MiataMike/RetroFuture-Dash/budget.png

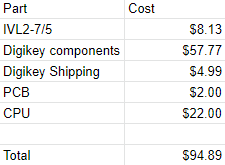
budget.png
