MiataMike/RetroFuture-Dash/BOM/2019-10-24T024712.xlsx

Index | Quantity | Part Number | Manufacturer Part Number | Description | Customer Reference | Available | Backorder | Unit Price | Extended Price USD
1 | 1 | PDV-P8103-ND | PDV-P8103 | PHOTOCELL 16-33KOHM |  | 1 | 0 | 0.89 | 0.89
2 | 1 | MBR0530CT-ND | MBR0530 | DIODE SCHOTTKY 30V 500MA SOD123 |  | 1 | 0 | 0.35 | 0.35
3 | 1 | 732-1416-ND | 7447054 | FIXED IND 10UH 2A 20 MOHM TH |  | 1 | 0 | 2.05 | 2.05
4 | 1 | 641-1310-1-ND | 1N4001-G | DIODE GEN PURP 50V 1A DO41 |  | 1 | 0 | 0.1 | 0.10
5 | 1 | 1N4749AFSCT-ND | 1N4749ATR | DIODE ZENER 24V 1W DO41 |  | 1 | 0 | 0.25 | 0.25
6 | 1 | 4N25SM-ND | 4N25SM | OPTOISO 4.17KV TRANS W/BASE 6SMD |  | 1 | 0 | 0.64 | 0.64
7 | 1 | P390ADCT-ND | ERJ-P06J391V | RES SMD 390 OHM 5% 1/2W 0805 |  | 1 | 0 | 0.13 | 0.13
8 | 2 | 399-1142-1-ND | C0805C471K5RACTU | CAP CER 470PF 50V X7R 0805 |  | 2 | 0 | 0.12 | 0.24
9 | 1 | RNCP0805FTD10K0CT-ND | RNCP0805FTD10K0 | RES 10K OHM 1% 1/4W 0805 |  | 1 | 0 | 0.1 | 0.10
10 | 1 | RMCF0805ZT0R00CT-ND | RMCF0805ZT0R00 | RES 0 OHM JUMPER 1/8W 0805 |  | 1 | 0 | 0.1 | 0.10
11 | 1 | LM340SX-12/NOPBCT-ND | LM340SX-12/NOPB | IC REG LIN 12V 1A DDPAK/TO263-3 |  | 1 | 0 | 1.58 | 1.58
12 | 1 | 1276-1768-1-ND | CL21C121JBANNNC | CAP CER 120PF 50V C0G/NP0 0805 |  | 1 | 0 | 0.1 | 0.10
13 | 1 | A126334CT-ND | CRG0805F11K | RES SMD 11K OHM 1% 1/8W 0805 |  | 1 | 0 | 0.1 | 0.10
14 | 1 | 311-205KCRCT-ND | RC0805FR-07205KL | RES SMD 205K OHM 1% 1/8W 0805 |  | 1 | 0 | 0.1 | 0.10
15 | 1 | ML07G-1-ND | 8125/07 100 | CBL RIBN 7COND 0.100 GRAY 1' |  | 0 | 1 | 3.3 | 3.30
16 | 1 | 493-11353-1-ND | UPW1E4R7MDD1TD | CAP ALUM 4.7UF 20% 25V RADIAL |  | 1 | 0 | 0.29 | 0.29
17 | 4 | 399-1177-1-ND | C0805C104Z5VACTU | CAP CER 0.1UF 50V Y5V 0805 |  | 4 | 0 | 0.1 | 0.40
18 | 1 | 490-10751-1-ND | GRM21BR61H475KE51L | CAP CER 4.7UF 50V X5R 0805 |  | 1 | 0 | 0.37 | 0.37
19 | 1 | 1276-2880-1-ND | CL31A475KAHNNNE | CAP CER 4.7UF 25V X5R 1206 |  | 1 | 0 | 0.22 | 0.22
20 | 1 | 1276-2903-1-ND | CL21A225KPFNNWE | CAP CER 2.2UF 10V X5R 0805 |  | 1 | 0 | 0.11 | 0.11
21 | 1 | MAX6920AWP+-ND | MAX6920AWP+ | IC DRVR VFD TUBE SRL 20SOIC |  | 1 | 0 | 5.59 | 5.59
22 | 1 | 296-2701-1-ND | TPS76325DBVT | IC REG LINEAR 2.5V 150MA SOT23-5 |  | 1 | 0 | 0.93 | 0.93
23 | 1 | 1568-1981-ND | COM-14965 | LUMINI LED RING 3" 60XAPA102-202 |  | 1 | 0 | 25.95 | 25.95
24 | 3 | A27628CT-ND | 61988-2 | CONN QC RCPT/TAB 18-22AWG 0.250 |  | 3 | 0 | 0.35 | 1.05
25 | 1 | CN528B-25-ND | 1569-22-1-0500-001-1-TS | HOOK-UP STRND 22AWG 300V BLK 25' |  | 1 | 0 | 5.91 | 5.91
26 | 1 | A132500-ND | 130046 | CONN RING CIRC 16-22AWG M6 CRIMP |  | 1 | 0 | 0.45 | 0.45
27 | 1 | LM1084ISX-5.0/NOPBCT-ND | LM1084ISX-5.0/NOPB | IC REG LIN 5V 5A DDPAK/TO263-3 |  | 1 | 0 | 2.65 | 2.65
28 | 1 | 296-38771-1-ND | LMR64010XMFX/NOPB | IC REG BOOST ADJ 1A SOT23-5 |  | 1 | 0 | 1.6 | 1.60
29 | 4 | 1772-1976-ND | 4532-440-AL-7 | HEX STANDOFF #4-40 ALUMINUM 3/8" |  | 4 | 0 | 0.38 | 1.52
30 | 1 | 36-9600-ND | 9600 | HEX NUT 1/4" STEEL 4-40 |  | 1 | 0 | 0.1 | 0.10
31 | 6 | 36-9900-ND | 9900 | MACHINE SCREW PAN PHILLIPS 4-40 |  | 6 | 0 | 0.1 | 0.60
