MiataMike/RetroFuture-Dash/DesignVFD-Ring.brd

## EAGLE design DesignVFD-Ring.brd (2019-10-30)

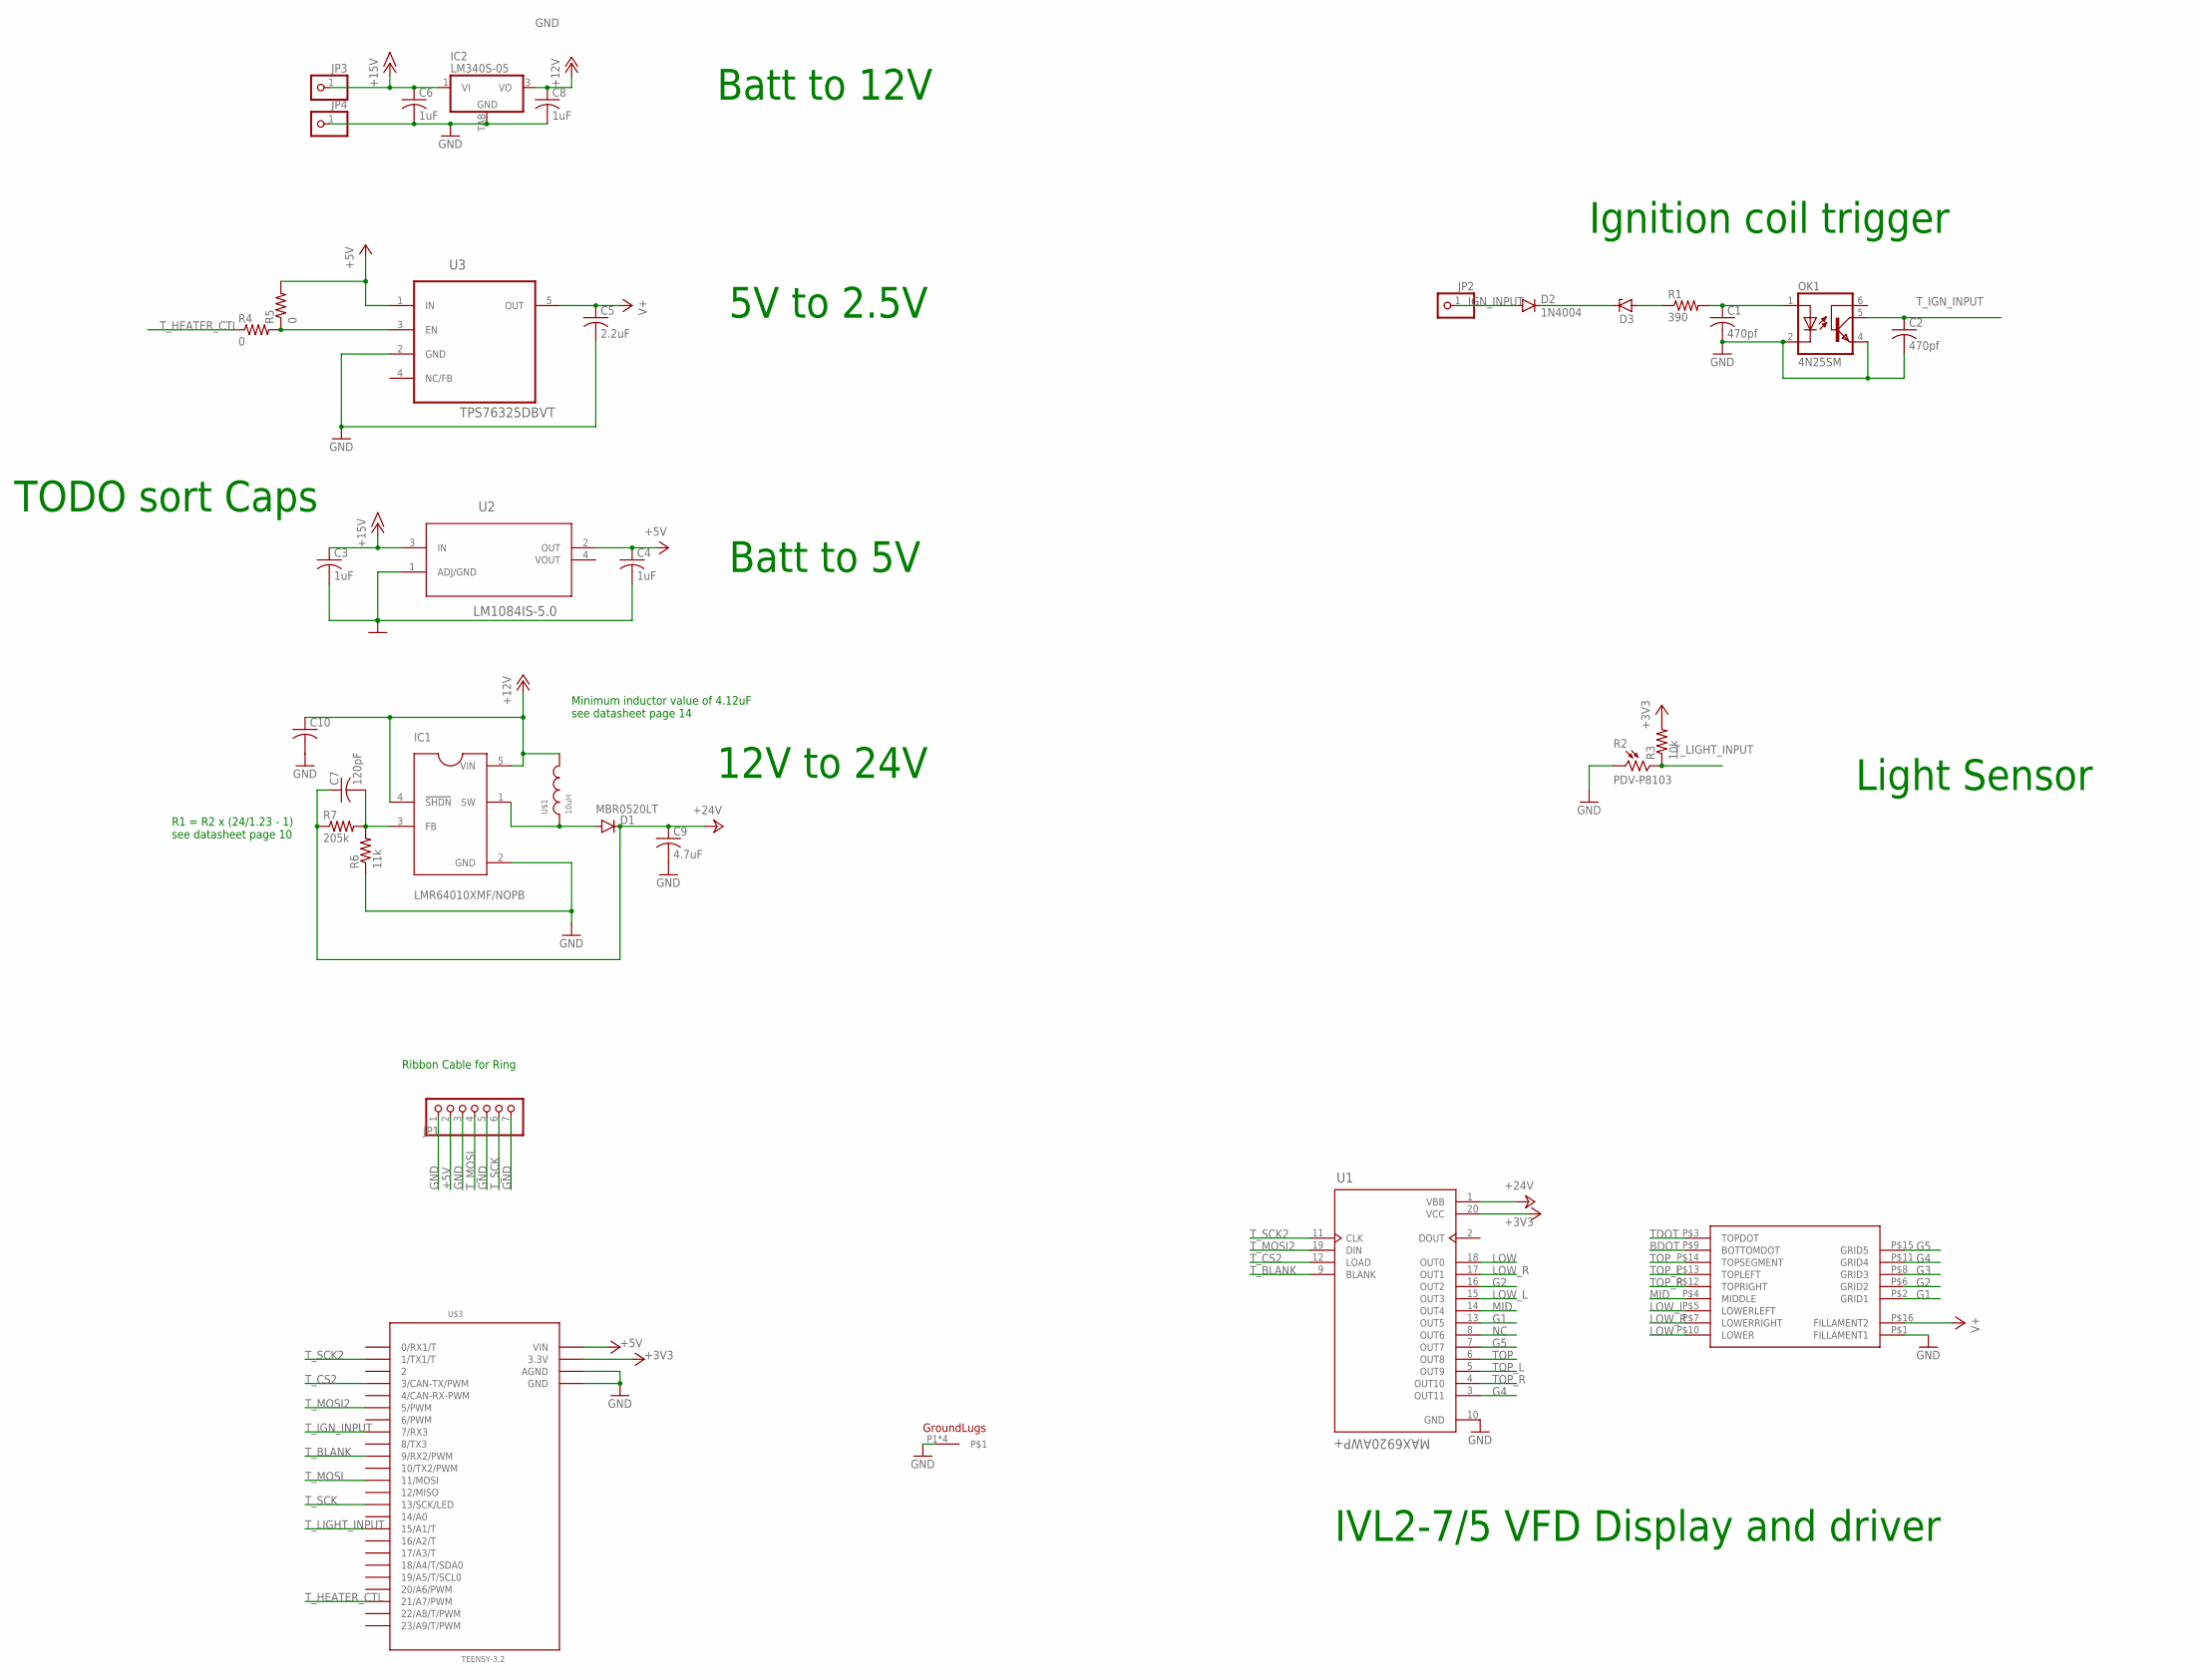
[picture p2: schematic DesignVFD-Ring.sch]

Parts:
C1, C2: 470pf; C0805
C3, C4, C6, C8: 1uF; C0805
C5: 2.2uF; C0805
C7: 120pF; C0805
C9: 4.7uF; C0805
C10: C-US025-050X050; C025-050X050
D1: MBR0520LT; SOD123
D2: 1N4004; DO41-10
D3: ZENER-DIODEDO41Z10; DO41Z10
IC1: LMR64010XMF/NOPB; SOT95P280X145-5N
IC2: LM340S-05; TO263-3
JP1: PINHD-1X7; 1X07
JP2, JP3, JP4: PINHD-1X1; 1X01
OK1: 4N25SM; DIL6-SMD
R1: 390; R0805
R2: PDV-P8103; PHODET_PDV-P8103
R3: 10k; R0805
R4, R5: 0; R0805
R6: 11k; R0805
R7: 205k; R0805
U1: MAX6920AWP+; SOIC127P1032X265-20N
U2: LM1084IS-5.0; TO254P1435X457-3N
U3: TPS76325DBVT; SOT95P280X145-5N
U$1: 10uH; 732-1416-ND
U$2: IVL2-7/5
U$3: TEENSY-3.2; TEENSY3.2
U$4: LUMINI3; STANDOFF-ELECTRICAL

Connections:
+3V3: R3.2, U1.20 (VCC), U$3.3V3+ (3.3V)
+5V: C4.1, JP1.2, R5.2, U2.2 (OUT), U3.1 (IN), U$3.VIN
+12V: C8.1, C10.1, IC1.4 (!SHDN), IC1.5 (VIN), IC2.3 (VO), U$1.P$2
+15V: C3.1, C6.1, IC2.1 (VI), JP3.1, U2.3 (IN)
+24V: C7.1, C9.1, D1.C, R7.1, U1.1 (VBB)
BDOT: U$2.P$9 (BOTTOMDOT)
G1: U1.13 (OUT5), U$2.P$2 (GRID1)
G2: U1.16 (OUT2), U$2.P$6 (GRID2)
G3: U$2.P$8 (GRID3)
G4: U1.3 (OUT11), U$2.P$11 (GRID4)
G5: U1.7 (OUT7), U$2.P$15 (GRID5)
GND: C1.2, C2.2, C3.2, C4.2, C5.2, C6.2, C8.2, C9.2, C10.2, IC1.2 (GND), IC2.TAB (GND), JP1.1, JP1.3, JP1.5, JP1.7, JP4.1, OK1.2 (C), OK1.4 (EMI), R2.1, R6.1, U1.10 (GND), U2.1 (ADJ/GND), U3.2 (GND), U$2.P$1 (FILLAMENT1), U$3.AGND, U$3.GND, U$4.P1, U$4.P2, U$4.P3, U$4.P4
IGN_INPUT: D2.A, JP2.1
LOW: U1.18 (OUT0), U$2.P$10 (LOWER)
LOW_L: U1.15 (OUT3), U$2.P$5 (LOWERLEFT)
LOW_R: U1.17 (OUT1), U$2.P$7 (LOWERRIGHT)
MID: U1.14 (OUT4), U$2.P$4 (MIDDLE)
unnamed: R4.2, R5.1, U3.3 (EN)
unnamed: D2.C, D3.C
unnamed: D3.A, R1.1
unnamed: C1.1, OK1.1 (A), R1.2
unnamed: D1.A, IC1.1 (SW), U$1.P$1
unnamed: C7.2, IC1.3 (FB), R6.2, R7.2
NC: U1.8 (OUT6)
TDOT: U$2.P$3 (TOPDOT)
TOP: U1.6 (OUT8), U$2.P$14 (TOPSEGMENT)
TOP_L: U1.5 (OUT9), U$2.P$13 (TOPLEFT)
TOP_R: U1.4 (OUT10), U$2.P$12 (TOPRIGHT)
T_BLANK: U1.9 (BLANK), U$3.9 (9/RX2/PWM)
T_CS2: U1.12 (LOAD), U$3.3 (3/CAN-TX/PWM)
T_HEATER_CTL: R4.1, U$3.21 (21/A7/PWM)
T_IGN_INPUT: C2.1, OK1.5 (COL), U$3.7 (7/RX3)
T_LIGHT_INPUT: R2.2, R3.1, U$3.15 (15/A1/T)
T_MOSI: JP1.4, U$3.11 (11/MOSI)
T_MOSI2: U1.19 (DIN), U$3.5 (5/PWM)
T_SCK: JP1.6, U$3.13 (13/SCK/LED)
T_SCK2: U1.11 (CLK), U$3.1 (1/TX1/T)
V+: C5.1, U3.5 (OUT), U$2.P$16 (FILLAMENT2)

Notes on the sheet:
Ribbon Cable for Ring
TODO sort Caps
Batt to 12V
5V to 2.5V
Batt to 5V
12V to 24V
Ignition coil trigger
IVL2-7/5 VFD Display and driver
Light Sensor
R1 = R2 x (24/1.23 - 1) see datasheet page 10
Minimum inductor value of 4.12uF see datasheet page 14

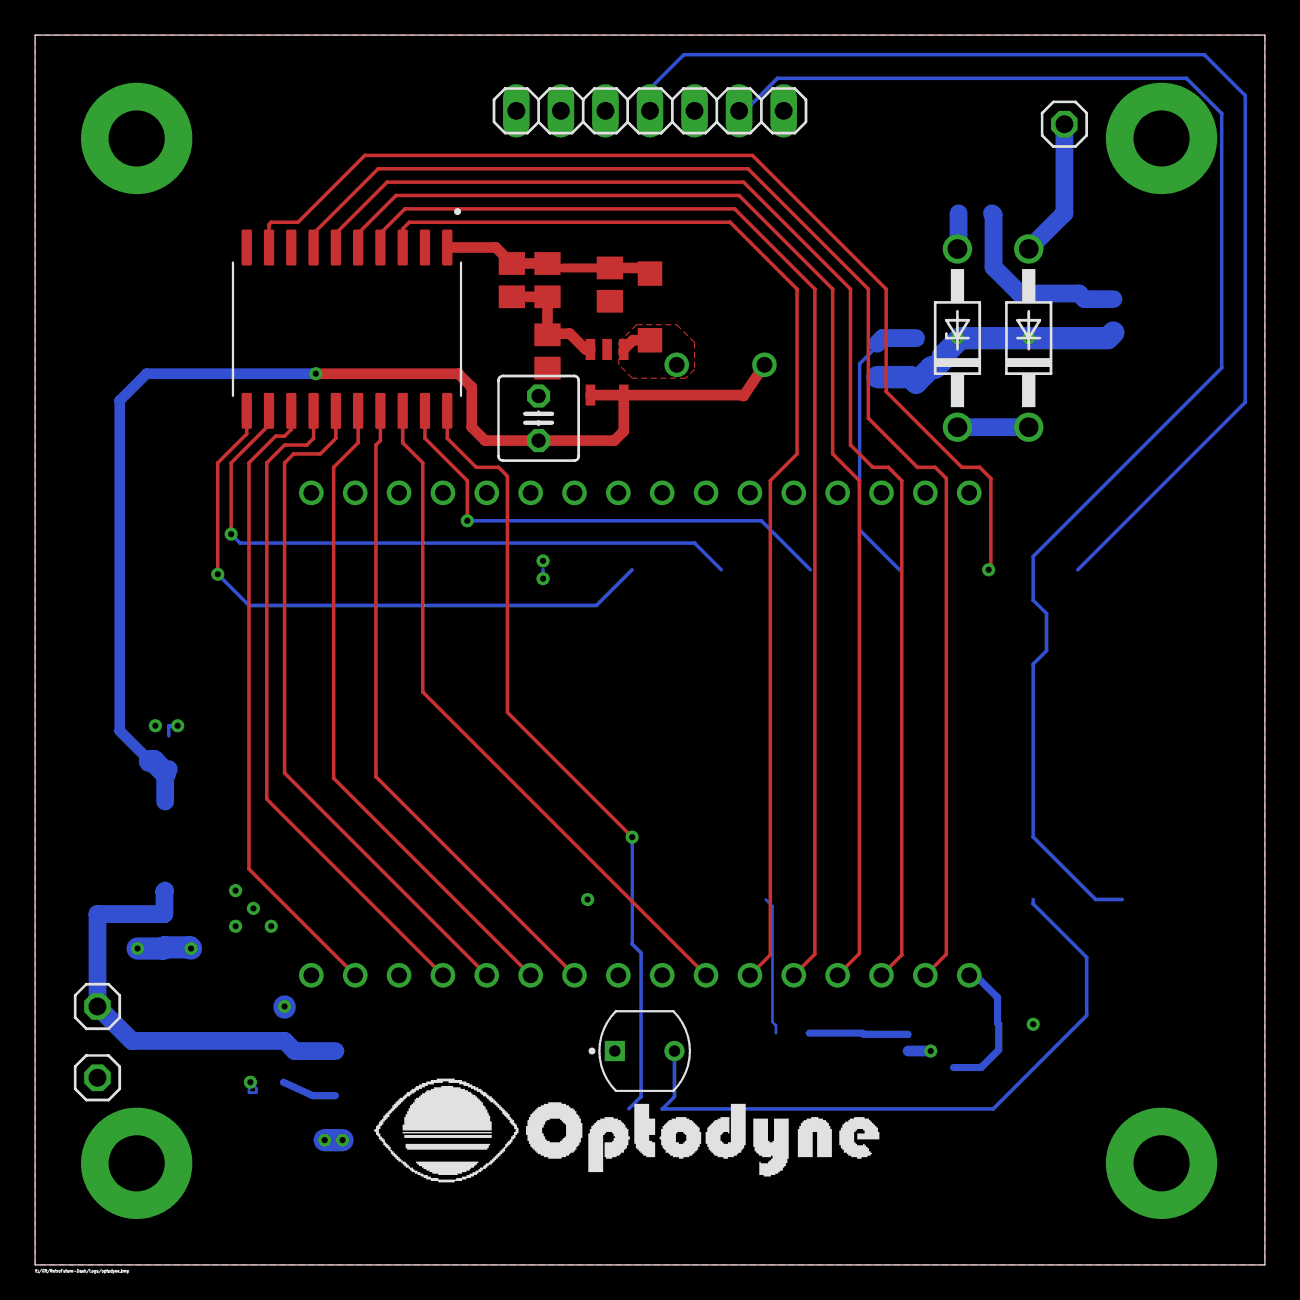
[picture p3: board DesignVFD-Ring.brd from above]

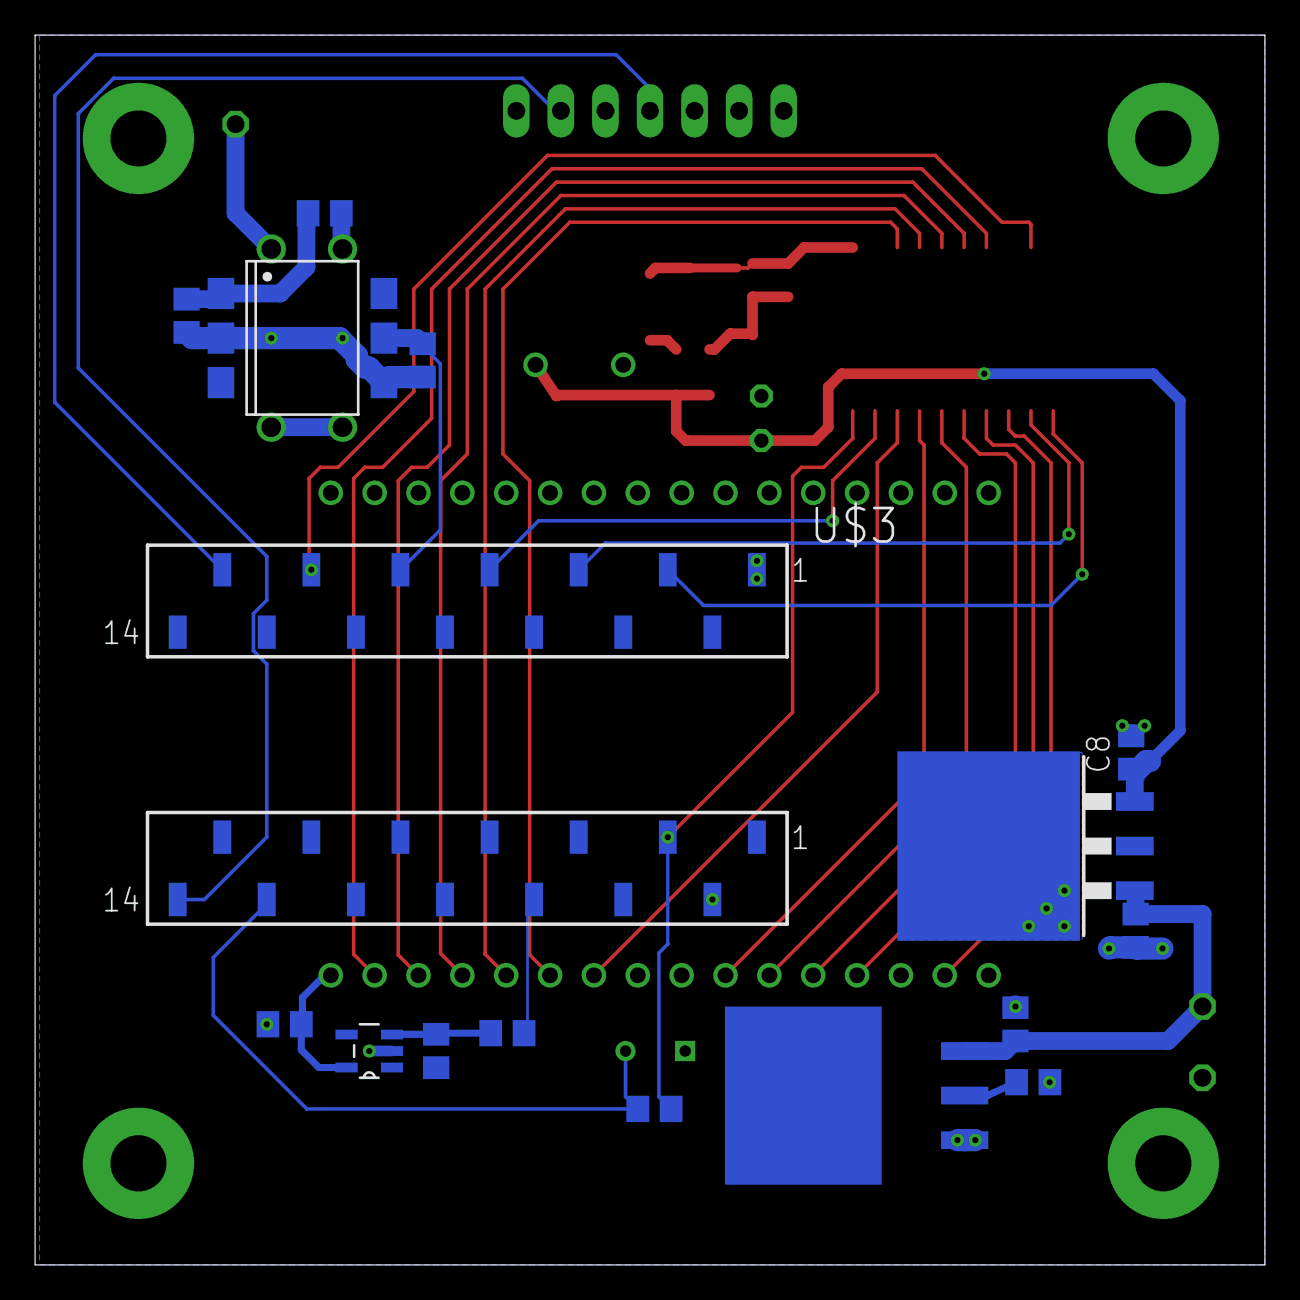
[picture p4: board DesignVFD-Ring.brd from below]

Board: 2 copper layers, 70.1 x 70.1 mm, 34 parts (16 on the bottom side), 34 nets.
