MiataMike/RetroFuture-Dash/LuMini_3Inch.brd

## EAGLE design LuMini_3Inch.brd (2019-10-24)

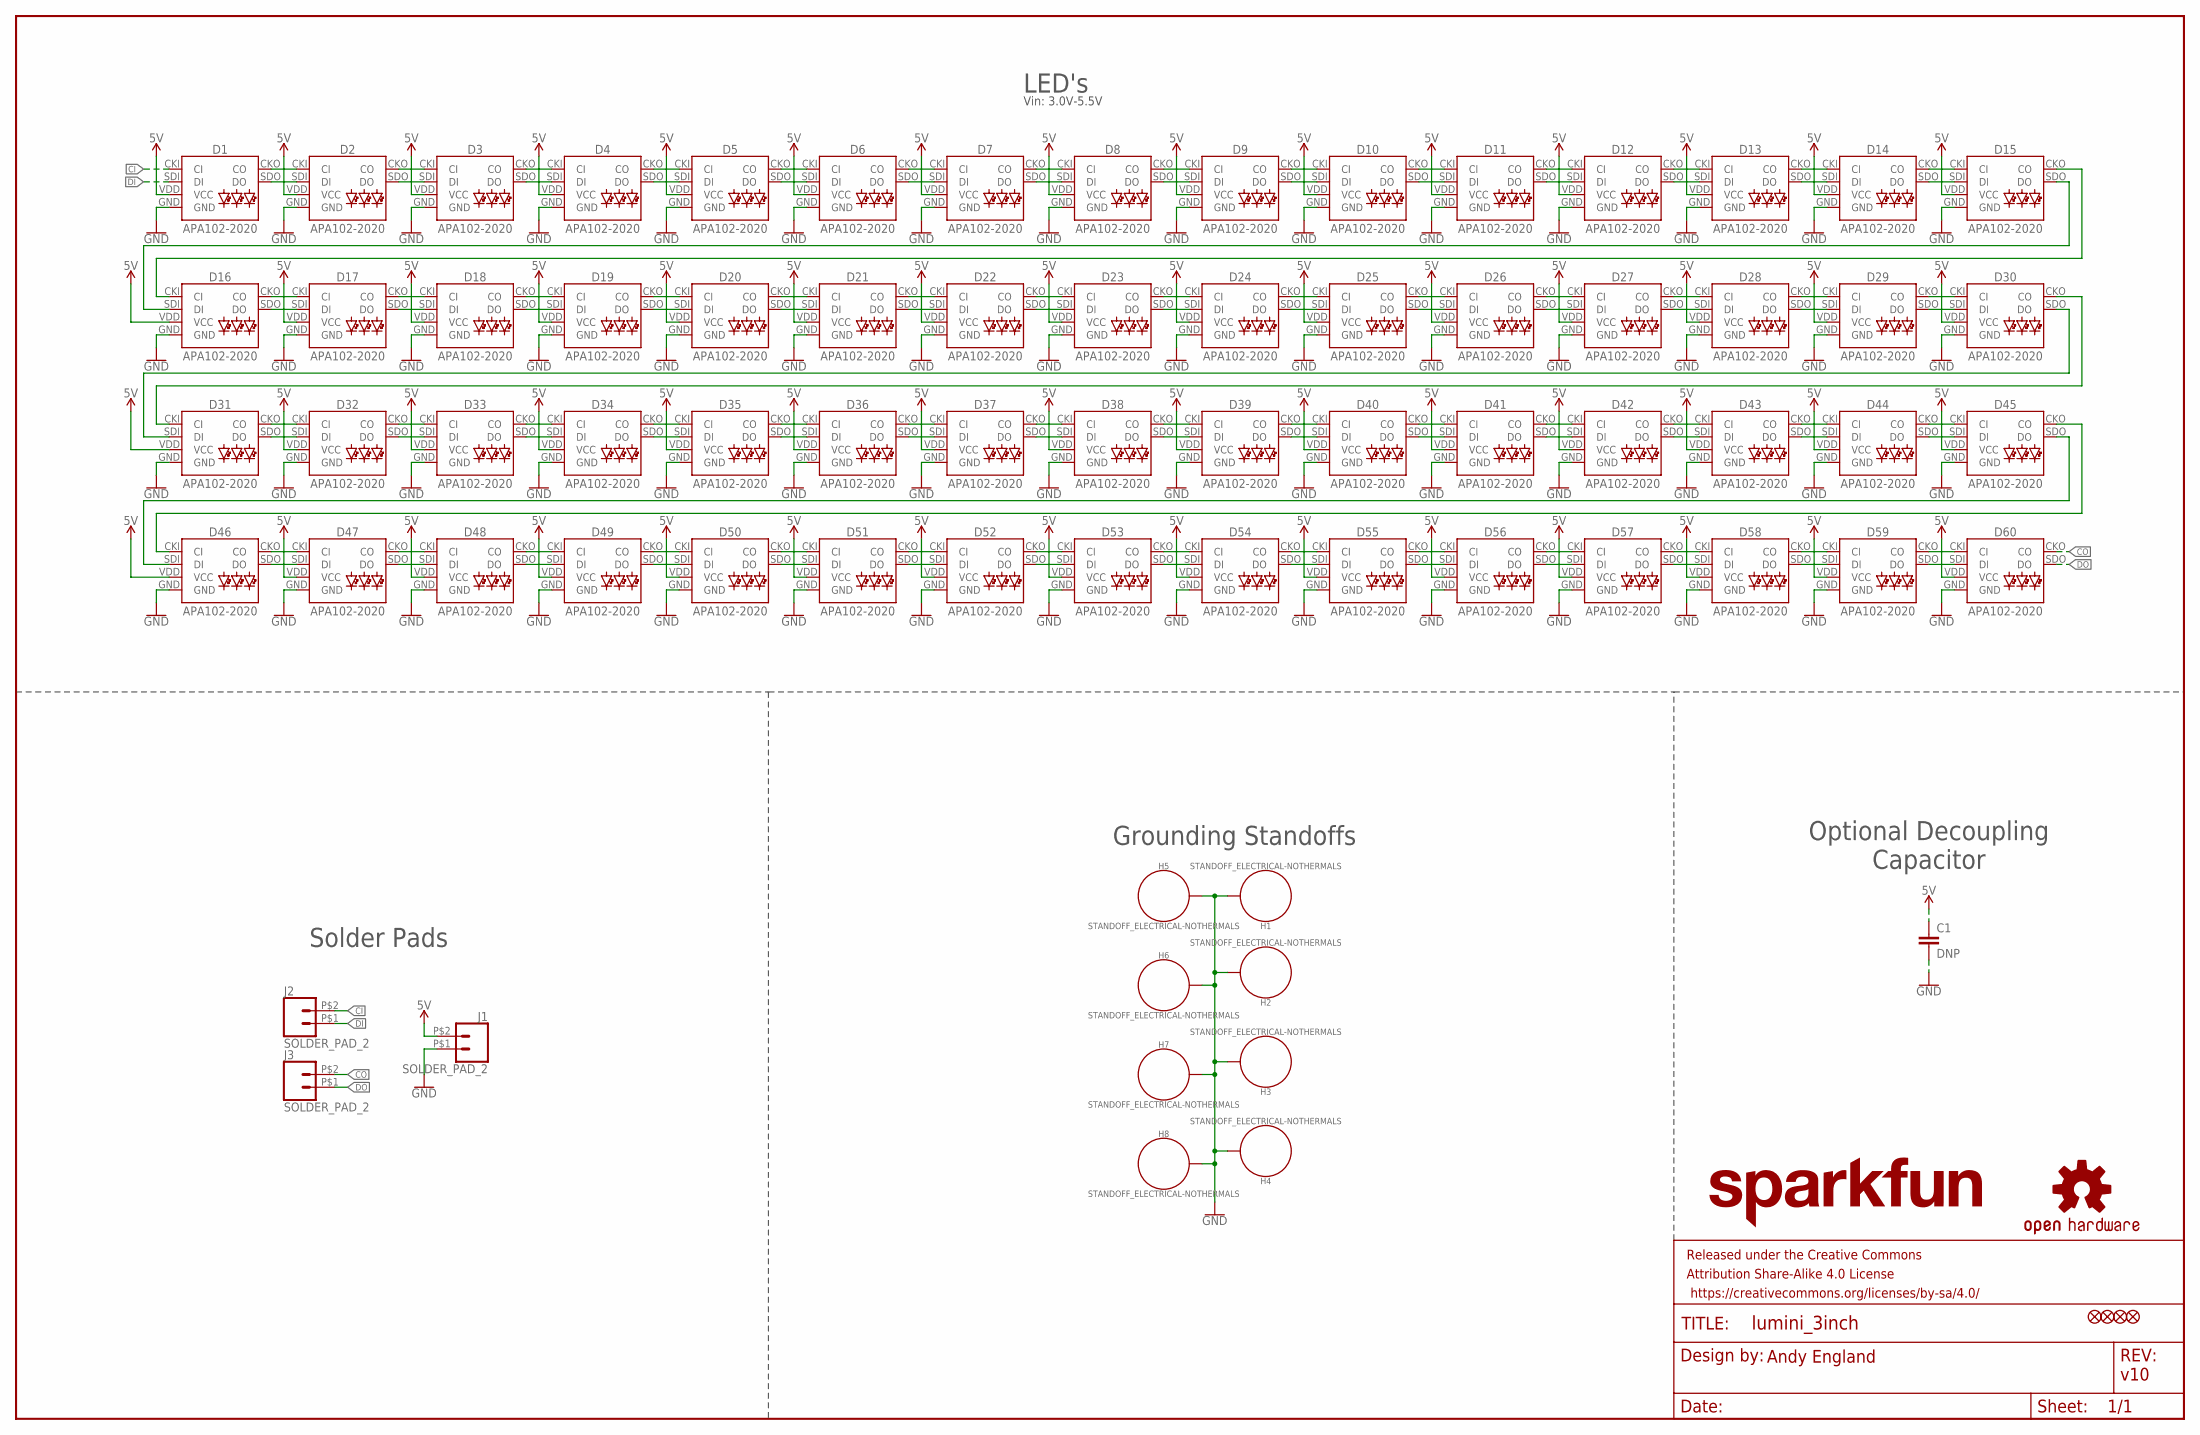
[picture p5: schematic LuMini_3Inch.sch]

Parts:
C1: DNP; 1206
D1, D2, D3, D4, D5, D6, D7, D8, D9, D10, D11, D12, D13, D14, D15, D16, D17, D18, D19, D20, D21, D22, D23, D24, D25, D26, D27, D28, D29, D30, D31, D32, D33, D34, D35, D36, D37, D38, D39, D40, D41, D42, D43, D44, D45, D46, D47, D48, D49, D50, D51, D52, D53, D54, D55, D56, D57, D58, D59, D60: APA102-2020
FD1, FD2, FD3, FD4: FIDUCIALUFIDUCIAL; FIDUCIAL-MICRO
FRAME1: FRAME-LEDGER; CREATIVE_COMMONS
H1, H2, H3, H4, H5, H6, H7, H8: STANDOFF_ELECTRICAL-NOTHERMALS; STANDOFF-ELECTRICAL-NOTHERMALS
J1, J2, J3: SOLDER_PAD_2
LOGO1: OSHW-LOGOS; OSHW-LOGO-S
LOGO2: SFE_LOGO_NAME.1_INCH; SFE_LOGO_NAME_.1

Connections:
5V: C1.1, D1.VDD (VCC), D2.VDD (VCC), D3.VDD (VCC), D4.VDD (VCC), D5.VDD (VCC), D6.VDD (VCC), D7.VDD (VCC), D8.VDD (VCC), D9.VDD (VCC), D10.VDD (VCC), D11.VDD (VCC), D12.VDD (VCC), D13.VDD (VCC), D14.VDD (VCC), D15.VDD (VCC), D16.VDD (VCC), D17.VDD (VCC), D18.VDD (VCC), D19.VDD (VCC), D20.VDD (VCC), D21.VDD (VCC), D22.VDD (VCC), D23.VDD (VCC), D24.VDD (VCC), D25.VDD (VCC), D26.VDD (VCC), D27.VDD (VCC), D28.VDD (VCC), D29.VDD (VCC), D30.VDD (VCC), D31.VDD (VCC), D32.VDD (VCC), D33.VDD (VCC), D34.VDD (VCC), D35.VDD (VCC), D36.VDD (VCC), D37.VDD (VCC), D38.VDD (VCC), D39.VDD (VCC), D40.VDD (VCC), D41.VDD (VCC), D42.VDD (VCC), D43.VDD (VCC), D44.VDD (VCC), D45.VDD (VCC), D46.VDD (VCC), D47.VDD (VCC), D48.VDD (VCC), D49.VDD (VCC), D50.VDD (VCC), D51.VDD (VCC), D52.VDD (VCC), D53.VDD (VCC), D54.VDD (VCC), D55.VDD (VCC), D56.VDD (VCC), D57.VDD (VCC), D58.VDD (VCC), D59.VDD (VCC), D60.VDD (VCC), J1.P$2 (2)
CI: D1.CKI (CI), J2.P$2 (2)
CO: D60.CKO (CO), J3.P$2 (2)
DI: D1.SDI (DI), J2.P$1 (1)
DO: D60.SDO (DO), J3.P$1 (1)
GND: C1.2, D1.GND, D2.GND, D3.GND, D4.GND, D5.GND, D6.GND, D7.GND, D8.GND, D9.GND, D10.GND, D11.GND, D12.GND, D13.GND, D14.GND, D15.GND, D16.GND, D17.GND, D18.GND, D19.GND, D20.GND, D21.GND, D22.GND, D23.GND, D24.GND, D25.GND, D26.GND, D27.GND, D28.GND, D29.GND, D30.GND, D31.GND, D32.GND, D33.GND, D34.GND, D35.GND, D36.GND, D37.GND, D38.GND, D39.GND, D40.GND, D41.GND, D42.GND, D43.GND, D44.GND, D45.GND, D46.GND, D47.GND, D48.GND, D49.GND, D50.GND, D51.GND, D52.GND, D53.GND, D54.GND, D55.GND, D56.GND, D57.GND, D58.GND, D59.GND, D60.GND, H1.P1, H2.P1, H3.P1, H4.P1, H5.P1, H6.P1, H7.P1, H8.P1, J1.P$1 (1)
unnamed: D4.CKO (CO), D5.CKI (CI)
unnamed: D1.CKO (CO), D2.CKI (CI)
unnamed: D1.SDO (DO), D2.SDI (DI)
unnamed: D2.CKO (CO), D3.CKI (CI)
unnamed: D2.SDO (DO), D3.SDI (DI)
unnamed: D3.CKO (CO), D4.CKI (CI)
unnamed: D3.SDO (DO), D4.SDI (DI)
unnamed: D4.SDO (DO), D5.SDI (DI)
unnamed: D5.CKO (CO), D6.CKI (CI)
unnamed: D5.SDO (DO), D6.SDI (DI)
unnamed: D6.CKO (CO), D7.CKI (CI)
unnamed: D6.SDO (DO), D7.SDI (DI)
unnamed: D7.CKO (CO), D8.CKI (CI)
unnamed: D7.SDO (DO), D8.SDI (DI)
unnamed: D16.SDO (DO), D17.SDI (DI)
unnamed: D20.SDO (DO), D21.SDI (DI)
unnamed: D9.CKO (CO), D10.CKI (CI)
unnamed: D9.SDO (DO), D10.SDI (DI)
unnamed: D10.CKO (CO), D11.CKI (CI)
unnamed: D10.SDO (DO), D11.SDI (DI)
unnamed: D11.CKO (CO), D12.CKI (CI)
unnamed: D11.SDO (DO), D12.SDI (DI)
unnamed: D12.CKO (CO), D13.CKI (CI)
unnamed: D12.SDO (DO), D13.SDI (DI)
unnamed: D13.CKO (CO), D14.CKI (CI)
unnamed: D13.SDO (DO), D14.SDI (DI)
unnamed: D14.CKO (CO), D15.CKI (CI)
unnamed: D14.SDO (DO), D15.SDI (DI)
unnamed: D45.CKO (CO), D46.CKI (CI)
unnamed: D30.CKO (CO), D31.CKI (CI)
unnamed: D8.CKO (CO), D9.CKI (CI)
unnamed: D8.SDO (DO), D9.SDI (DI)
unnamed: D17.CKO (CO), D18.CKI (CI)
unnamed: D17.SDO (DO), D18.SDI (DI)
unnamed: D18.CKO (CO), D19.CKI (CI)
unnamed: D18.SDO (DO), D19.SDI (DI)
unnamed: D19.CKO (CO), D20.CKI (CI)
unnamed: D19.SDO (DO), D20.SDI (DI)
unnamed: D30.SDO (DO), D31.SDI (DI)
unnamed: D15.CKO (CO), D16.CKI (CI)
unnamed: D16.CKO (CO), D17.CKI (CI)
unnamed: D21.CKO (CO), D22.CKI (CI)
unnamed: D21.SDO (DO), D22.SDI (DI)
unnamed: D22.CKO (CO), D23.CKI (CI)
unnamed: D22.SDO (DO), D23.SDI (DI)
unnamed: D23.CKO (CO), D24.CKI (CI)
unnamed: D23.SDO (DO), D24.SDI (DI)
unnamed: D24.CKO (CO), D25.CKI (CI)
unnamed: D24.SDO (DO), D25.SDI (DI)
unnamed: D25.CKO (CO), D26.CKI (CI)
unnamed: D25.SDO (DO), D26.SDI (DI)
unnamed: D26.CKO (CO), D27.CKI (CI)
unnamed: D26.SDO (DO), D27.SDI (DI)
unnamed: D27.CKO (CO), D28.CKI (CI)
unnamed: D27.SDO (DO), D28.SDI (DI)
unnamed: D29.CKO (CO), D30.CKI (CI)
unnamed: D29.SDO (DO), D30.SDI (DI)
unnamed: D15.SDO (DO), D16.SDI (DI)
unnamed: D45.SDO (DO), D46.SDI (DI)
unnamed: D31.CKO (CO), D32.CKI (CI)
unnamed: D31.SDO (DO), D32.SDI (DI)
unnamed: D32.CKO (CO), D33.CKI (CI)
unnamed: D32.SDO (DO), D33.SDI (DI)
unnamed: D33.CKO (CO), D34.CKI (CI)
unnamed: D33.SDO (DO), D34.SDI (DI)
unnamed: D34.CKO (CO), D35.CKI (CI)
unnamed: D34.SDO (DO), D35.SDI (DI)
unnamed: D35.CKO (CO), D36.CKI (CI)
unnamed: D35.SDO (DO), D36.SDI (DI)
unnamed: D37.CKO (CO), D38.CKI (CI)
unnamed: D37.SDO (DO), D38.SDI (DI)
unnamed: D38.SDO (DO), D39.SDI (DI)
unnamed: D39.CKO (CO), D40.CKI (CI)
unnamed: D39.SDO (DO), D40.SDI (DI)
unnamed: D38.CKO (CO), D39.CKI (CI)
unnamed: D28.CKO (CO), D29.CKI (CI)
unnamed: D28.SDO (DO), D29.SDI (DI)
unnamed: D36.SDO (DO), D37.SDI (DI)
unnamed: D36.CKO (CO), D37.CKI (CI)
unnamed: D40.CKO (CO), D41.CKI (CI)
unnamed: D40.SDO (DO), D41.SDI (DI)
unnamed: D41.CKO (CO), D42.CKI (CI)
unnamed: D41.SDO (DO), D42.SDI (DI)
unnamed: D42.CKO (CO), D43.CKI (CI)
unnamed: D42.SDO (DO), D43.SDI (DI)
unnamed: D43.CKO (CO), D44.CKI (CI)
unnamed: D43.SDO (DO), D44.SDI (DI)
unnamed: D44.CKO (CO), D45.CKI (CI)
unnamed: D44.SDO (DO), D45.SDI (DI)
unnamed: D46.CKO (CO), D47.CKI (CI)
unnamed: D46.SDO (DO), D47.SDI (DI)
unnamed: D47.CKO (CO), D48.CKI (CI)
unnamed: D47.SDO (DO), D48.SDI (DI)
unnamed: D49.CKO (CO), D50.CKI (CI)
unnamed: D49.SDO (DO), D50.SDI (DI)
unnamed: D50.CKO (CO), D51.CKI (CI)
unnamed: D50.SDO (DO), D51.SDI (DI)
unnamed: D51.CKO (CO), D52.CKI (CI)
unnamed: D51.SDO (DO), D52.SDI (DI)
unnamed: D52.CKO (CO), D53.CKI (CI)
unnamed: D52.SDO (DO), D53.SDI (DI)
unnamed: D53.CKO (CO), D54.CKI (CI)
unnamed: D53.SDO (DO), D54.SDI (DI)
unnamed: D54.CKO (CO), D55.CKI (CI)
unnamed: D54.SDO (DO), D55.SDI (DI)
unnamed: D55.CKO (CO), D56.CKI (CI)
unnamed: D55.SDO (DO), D56.SDI (DI)
unnamed: D57.CKO (CO), D58.CKI (CI)
unnamed: D57.SDO (DO), D58.SDI (DI)
unnamed: D58.SDO (DO), D59.SDI (DI)
unnamed: D59.CKO (CO), D60.CKI (CI)
unnamed: D59.SDO (DO), D60.SDI (DI)
unnamed: D58.CKO (CO), D59.CKI (CI)
unnamed: D48.CKO (CO), D49.CKI (CI)
unnamed: D48.SDO (DO), D49.SDI (DI)
unnamed: D56.SDO (DO), D57.SDI (DI)
unnamed: D56.CKO (CO), D57.CKI (CI)
unnamed: D20.CKO (CO), D21.CKI (CI)

Notes on the sheet:
LED's
Grounding Standoffs
Andy England
v10
Vin: 3.0V-5.5V
Optional Decoupling Capacitor
Solder Pads

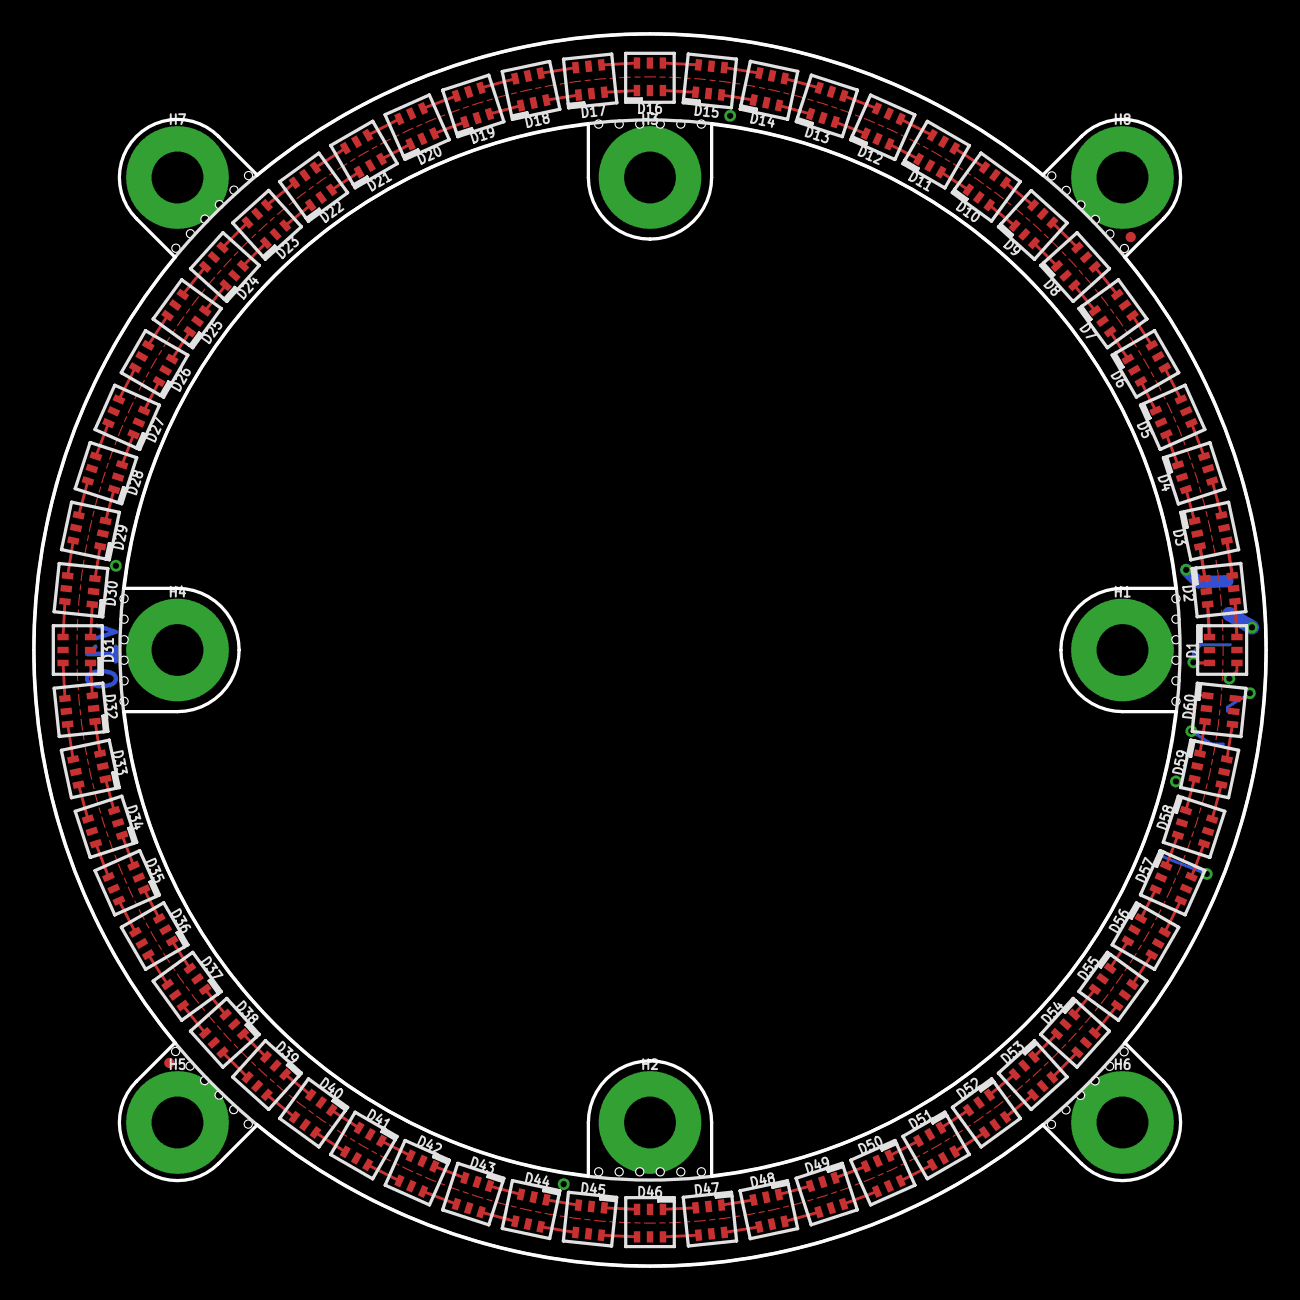
[picture p6: board LuMini_3Inch.brd from above]

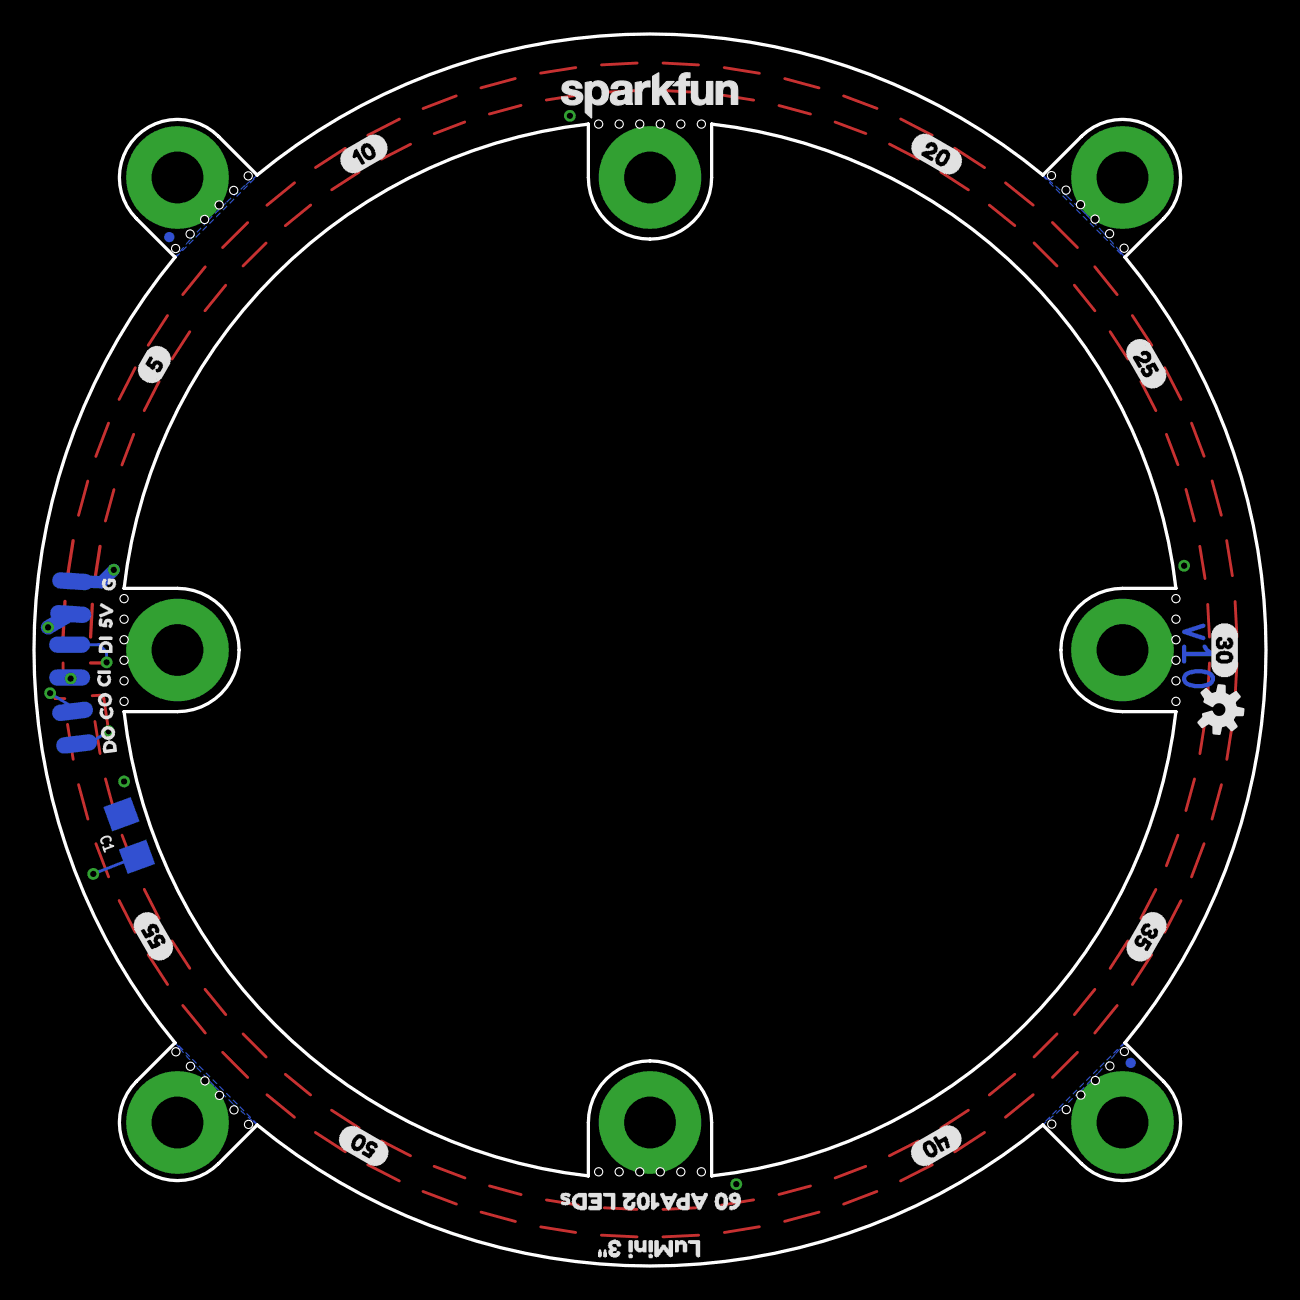
[picture p7: board LuMini_3Inch.brd from below]

Board: 2 copper layers, 76.2 x 76.2 mm, 97 parts (25 on the bottom side), 124 nets.

Other parts of the board:
U$1: LUMINI_3#2
U$2: 60_APA102_LEDS0
U$3: 54
U$4: 5V6
U$5: G4
U$6: 105
U$7: DO3
U$8: CO1
U$9: CI6
U$10: DI4
U$11: 207
U$12: 258
U$13: 309
U$14: 3510
U$15: 4011
U$16: 5013
U$17: 5514
U$18: ORDERING_INSTRUCTIONS
