MiataMike/RetroFuture-Dash/(commit log)

2019-10-19 Started Sch, added sockets for Teensy and Ring
    [DesignVFD-Ring.sch]
2019-10-19 downloaded some spreadsheets, added most parts, finished ignition input
    [DesignVFD-Ring.sch]
2019-10-19 Added IVL2/7-5
    [DesignVFD-Ring.sch]
2019-10-19 Initial Schematic complete
    [DesignVFD-Ring.sch]
2019-10-22 added 7th ribbon cable connection, verified SMPS values
    [DesignVFD-Ring.sch]
2019-10-23 created layout, sorted
    [DesignVFD-Ring.brd]
2019-10-24 24V reg layout
    [DesignVFD-Ring.brd]
2019-10-24 Replaced headers with Teensy device
    [DesignVFD-Ring.brd, DesignVFD-Ring.sch]
2019-10-24 Initial layout complete
    [DesignVFD-Ring.brd, DesignVFD-Ring.sch]
2019-10-24 Fine tuned IVL location, added lumini docs
    [DesignVFD-Ring.brd, LuMini_3Inch.brd, LuMini_3Inch.sch]
2019-10-24 added lumini ring
    [DesignVFD-Ring.brd, DesignVFD-Ring.sch, LuMini_3Inch.brd, LuMini_3Inch.sch]
2019-10-24 about to repin IVL
    [DesignVFD-Ring.brd, DesignVFD-Ring.sch, LuMini_3Inch.brd, LuMini_3Inch.sch]
2019-10-24 IVL complete
    [DesignVFD-Ring.brd, DesignVFD-Ring.sch]
2019-10-24 Passed ERC and DRC!
    [DesignVFD-Ring.brd, DesignVFD-Ring.sch]
2019-10-24 added aesthetic capacitor
    [DesignVFD-Ring.brd, DesignVFD-Ring.sch]
2019-10-24 rotated inductor
    [DesignVFD-Ring.brd]
2019-10-24 Saved $$ by reviewing BOM!
    [2019-10-24T020244.xlsx, 2019-10-24T021433.xlsx]
2019-10-24 added screws to bom
    [2019-10-24T021433.xlsx, 2019-10-24T024712.xlsx]
2019-10-25 created and added logo, removed board markings
    [DesignVFD-Ring.brd, DesignVFD-Ring.sch]
2019-10-26 cleaned up a bit
    [2019-10-24T024712.xlsx, DesignVFD-Ring.brd]
2019-10-30 changed logo, updated gerbers and created budget pic
    [DesignVFD-Ring.brd]
